Mr-OutLaw/Qadruper/CAD/Quadruped_Parts_v0.1a.dxf

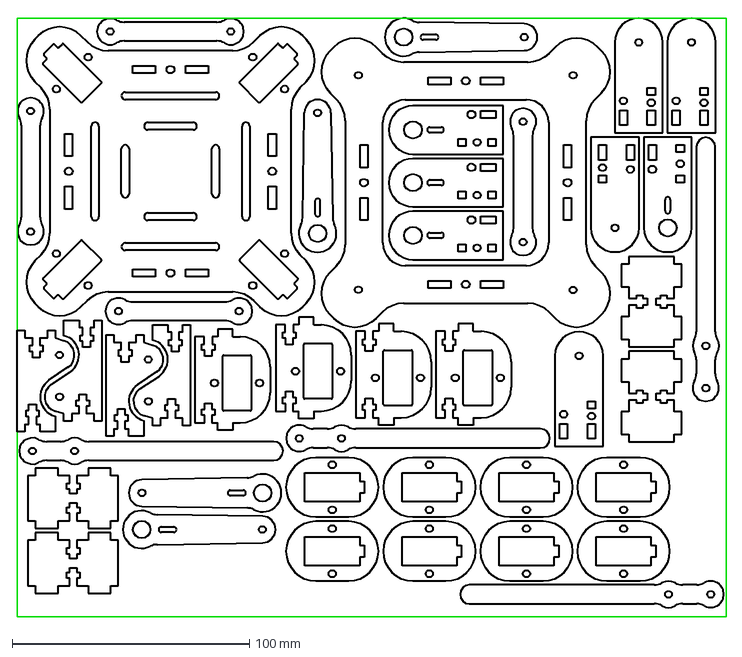
[picture p1: CAD file, 2017-09-03]
CAD/Quadruped_Parts_v0.1a.dxf
299.1 x 252.9 mm
